charles-park/m1s_ups/sch/m1s_ups-REV1.0_20230712.png

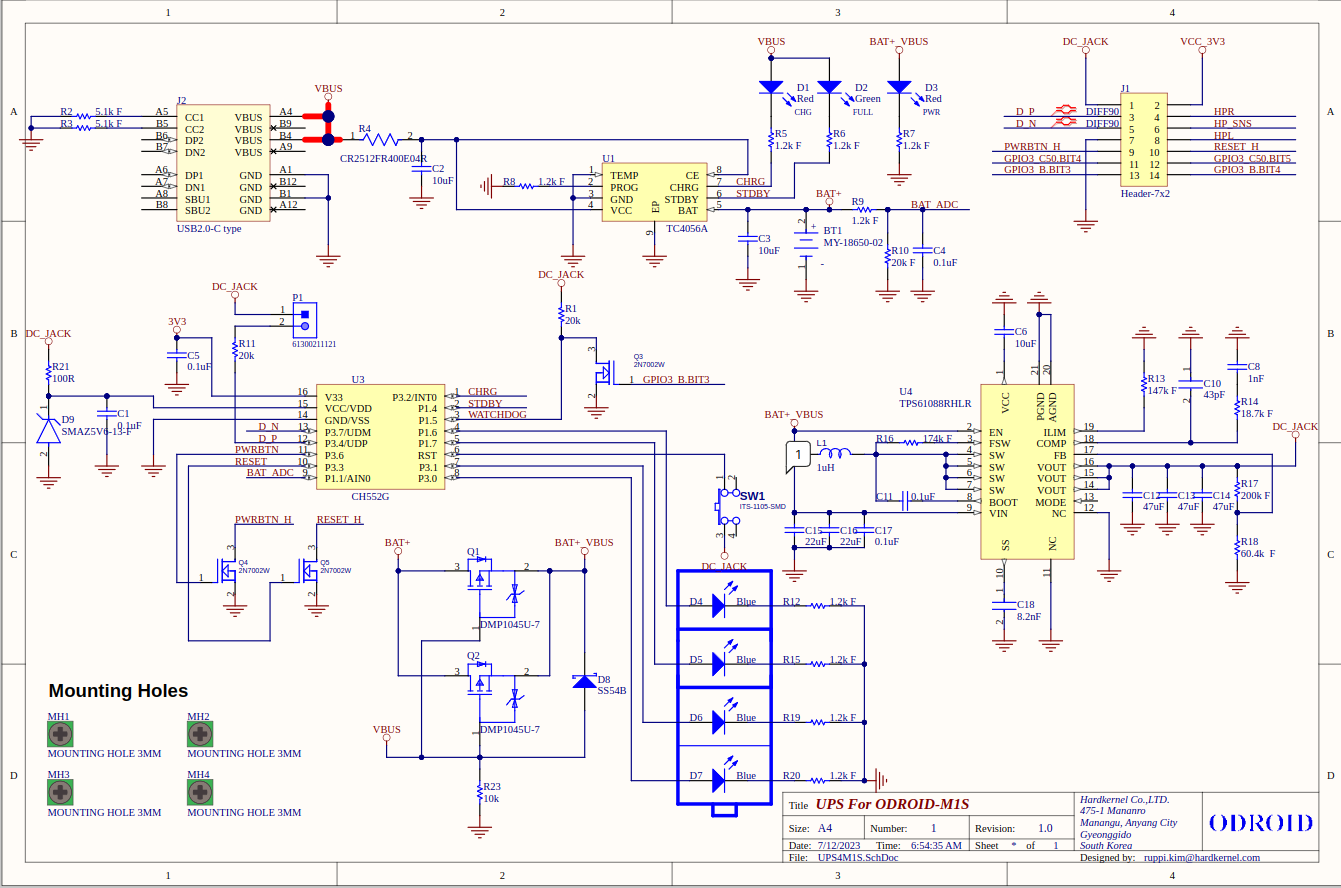
sch/m1s_ups-REV1.0_20230712.png
