charles-park/m1s_ups/sch/m1s_ups_rev1.0_230818.png

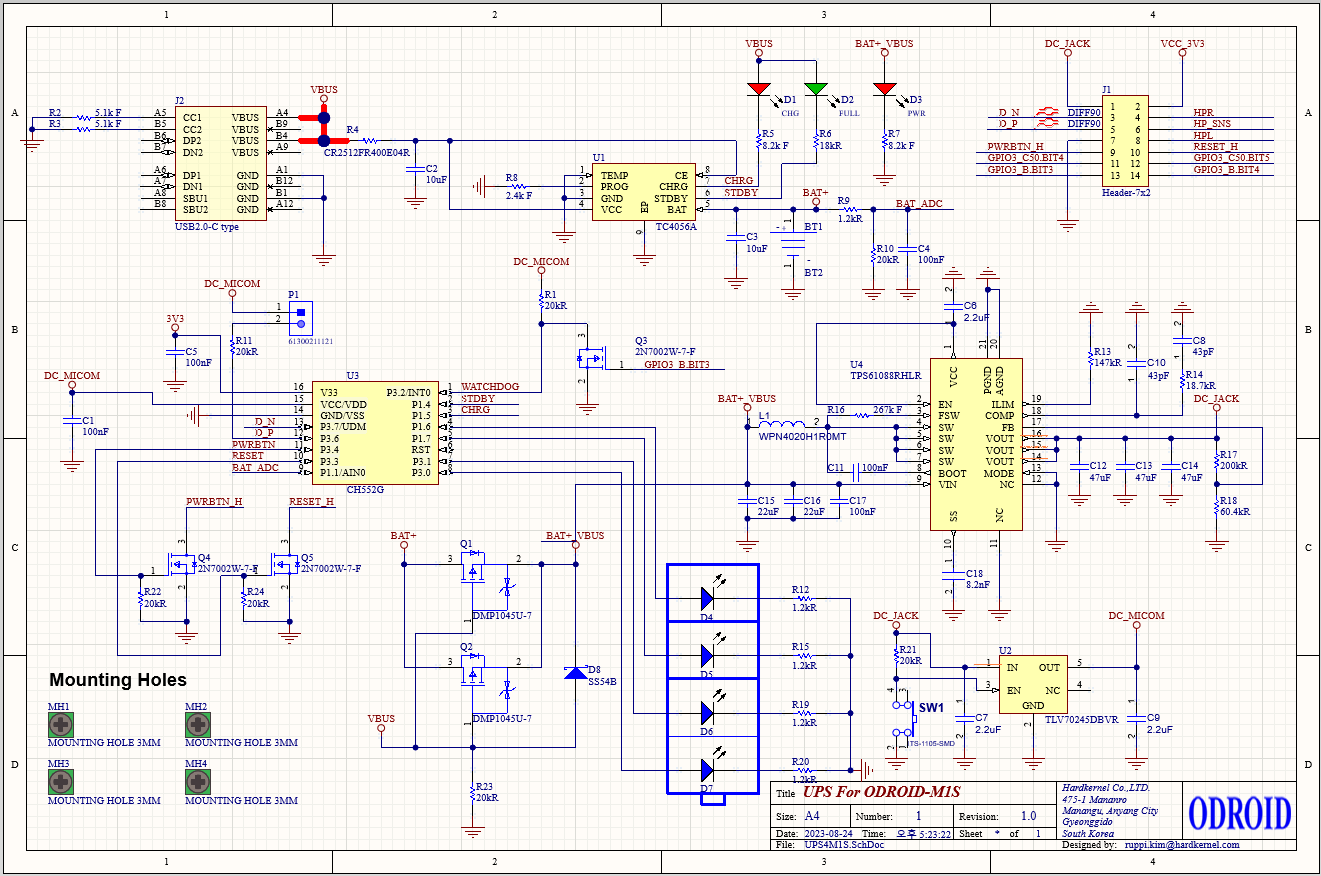
sch/m1s_ups_rev1.0_230818.png
