charles-park/m1s_ups/ups_fw/ups_fw.h

/*---------------------------------------------------------------------------*/
/**
 * @file ups_fw.h
 * @author charles-park (charles.park@hardkernel.com)
 * @brief M1S_UPS (Smart UPS Project)
 * @version 0.1
 * @date 2023-08-04
 *
 * @copyright Copyright (c) 2022
**/
/*---------------------------------------------------------------------------*/
#ifndef __UPS_FW_H__
#define __UPS_FW_H__

/*---------------------------------------------------------------------------*/
#include "include/ch5xx.h"

/*---------------------------------------------------------------------------*/
/* UPS System watchdog control */
/*---------------------------------------------------------------------------*/
#define GLOBAL_CFG_UNLOCK()     { SAFE_MOD = 0x55; SAFE_MOD = 0xAA;}
#define WDT_ENABLE()            ( GLOBAL_CFG |=  bWDOG_EN )
#define WDT_DISABLE()           ( GLOBAL_CFG &= ~bWDOG_EN )
#define WDT_CLR()               ( WDOG_COUNT  = 0 )

/* Use RESET_KEEP register to manage power states */
typedef union {
    struct {
        unsigned char   NotUsed             : 4;
        unsigned char   bGpioStatus         : 1;
        unsigned char   bRestartCondition   : 1;
        unsigned char   ePowerState         : 2;
    }   bits;
    unsigned char       byte;
}   regRESET_KEEP;

volatile regRESET_KEEP  rRESET_KEEP;

/*---------------------------------------------------------------------------*/
/* TC4056A Charger status check port */
/*---------------------------------------------------------------------------*/
/* CH552 GPIO P1.1 */
#define PORT_BAT_ADC    11

/* CH552 GPIO P1.4 */
#define PORT_LED_FULL   14

/* CH552 GPIO P1.5 */
#define PORT_LED_CHRG   15

/*---------------------------------------------------------------------------*/
/* Target watchdog control port */
/*---------------------------------------------------------------------------*/
/* CH552 GPIO P3.2 */
#define PORT_WATCHDOG   32

/*---------------------------------------------------------------------------*/
/* Target Power / Reset control port */
/*---------------------------------------------------------------------------*/
/* CH552 GPIO P3.6 */
#define PORT_CTL_POWER  34
/* CH552 GPIO P3.3 */
#define PORT_CTL_RESET  33

/*---------------------------------------------------------------------------*/
/* Battery level display port */
/*---------------------------------------------------------------------------*/
/* CH552 GPIO P3.0 */
#define PORT_LED_LV4    30
/* CH552 GPIO P3.1 */
#define PORT_LED_LV3    31
/* CH552 GPIO P1.7 */
#define PORT_LED_LV2    17
/* CH552 GPIO P1.6 */
#define PORT_LED_LV1    16

/*---------------------------------------------------------------------------*/
/* M1S_UPS H/W Value set-tup */
/*---------------------------------------------------------------------------*/
/* TLV70245DBVR LDO Output(4.5V) = 4500 mV */
#define MICOM_VDD_mV    4500

/* ADC 8 bits (256). mV resolution value */
//#define MICOM_ADC_RES   256
#define MICOM_ADC_RES   255
/* R9(1.2K) */
#define BAT_ADC_R1      1200
/* R10(20K) */
#define BAT_ADC_R2      20000

/*---------------------------------------------------------------------------*/
/* Battery Level (1 ~ 9) */
/* cal = 3500 + (level * 50) mV*/
/*---------------------------------------------------------------------------*/
#define BATTERY_LEVEL_3950mV    3950
#define BATTERY_LEVEL_3900mV    3900
#define BATTERY_LEVEL_3850mV    3850
#define BATTERY_LEVEL_3800mV    3800
#define BATTERY_LEVEL_3750mV    3750
#define BATTERY_LEVEL_3700mV    3700
#define BATTERY_LEVEL_3650mV    3650
#define BATTERY_LEVEL_3600mV    3600
#define BATTERY_LEVEL_3550mV    3550
/* Force off Battery level */
#define BATTERY_LEVEL_OFF       3300
#define BATTERY_BOOT_LEVEL      3500

/*---------------------------------------------------------------------------*/
/* Display Battery Level */
/*---------------------------------------------------------------------------*/
#define BATTERY_DISPLAY_LV4     BATTERY_LEVEL_3900mV
#define BATTERY_DISPLAY_LV3     BATTERY_LEVEL_3750mV
#define BATTERY_DISPLAY_LV2     BATTERY_LEVEL_3650mV
#define BATTERY_DISPLAY_LV1     BATTERY_LEVEL_3550mV

/*---------------------------------------------------------------------------*/
/* Set battery level for system power on */
/* Power on when battery charge condition detected.(default) */
/* 0     : Detect charging status.(default) */
/* 1 ~ 9 : BATTERY LEVEL, cal_volt = 3500 + (50 * value) */
/*---------------------------------------------------------------------------*/
__xdata unsigned long BatteryBootVolt = 0;

/*---------------------------------------------------------------------------*/
/* ADC Raw sample count. */
/*---------------------------------------------------------------------------*/
#define ADC_SAMPLE_CNT      10

/*---------------------------------------------------------------------------*/
/* 10 sec avr */
/*---------------------------------------------------------------------------*/
#define BAT_AVR_SAMPLE_CNT  20

__xdata float BatteryVoltSamples[BAT_AVR_SAMPLE_CNT];

/*---------------------------------------------------------------------------*/
/*
    Charger Status
                 | LED_CHARG_STATUS | LED_FULL_STATUS |
    Discharging  |         1        |        1        |
    Charging     |         0        |        1        |
    Full Charged |         1        |        0        |
    Error        |         0        |        0        | Battery Removed.
*/
/*---------------------------------------------------------------------------*/
__xdata bool LED_CHRG_STATUS = false;
__xdata bool LED_FULL_STATUS = false;

/*---------------------------------------------------------------------------*/
/* Battery level indicator LED status */
/*---------------------------------------------------------------------------*/
__xdata bool LED_LV1_STATUS = false;
__xdata bool LED_LV2_STATUS = false;
__xdata bool LED_LV3_STATUS = false;
__xdata bool LED_LV4_STATUS = false;

/*---------------------------------------------------------------------------*/
/* Serial Protocol */
/*---------------------------------------------------------------------------*/
#define PROTOCOL_SIZE   4

__xdata char Protocol[PROTOCOL_SIZE];

/*---------------------------------------------------------------------------*/
/* Power State */
/*---------------------------------------------------------------------------*/
enum {
    ePOWER_INIT = 0,
    ePOWER_ON,
    ePOWER_OFF,
    ePOWER_END,
}   ePOWER_STATE;

/*---------------------------------------------------------------------------*/
/* Battery Status */
/*---------------------------------------------------------------------------*/
enum {
    eBATTERY_DISCHARGING = 0,
    eBATTERY_CHARGING,
    eBATTERY_FULL,
    eBATTERY_REMOVED,
    eBATTERY_END,
}   eBATTERY_STATUS;

__xdata enum eBATTERY_STATUS BatteryStatus = eBATTERY_REMOVED;

/*---------------------------------------------------------------------------*/
/* Main Loop Control */
/*---------------------------------------------------------------------------*/
#define TARGET_RESET_DELAY      100

/* Main loop period */
#define PERIOD_LOOP_MILLIS      500

/* Off state period 2 sec (2000 - PERIOD_LOOP_MILLIS) */
#define PEROID_OFF_MILLIS       1500

/* Error display delay */
#define POWEROFF_LED_DELAY      100

__xdata unsigned long MillisLoop        = 0;
__xdata unsigned long BatteryAvrVolt    = 0;

/*---------------------------------------------------------------------------*/
/* Auto repeat data control */
/*---------------------------------------------------------------------------*/
__xdata unsigned long PeriodRequestBatteryLevel   = 0;
__xdata unsigned long MillisRequestBatteryLevel   = 0;

__xdata unsigned long PeriodRequestBatteryVoltage = 0;
__xdata unsigned long MillisRequestBatteryVoltage = 0;

__xdata unsigned long PeriodRequestChagerStatus   = 0;
__xdata unsigned long MillisRequestChagerStatus   = 0;

/*---------------------------------------------------------------------------*/
/* Target reset(watchdog) control */
/*---------------------------------------------------------------------------*/
__xdata unsigned long PeriodRequestWatchdogTime = 0;
__xdata unsigned long MillisRequestWatchdogTime = 0;

/*---------------------------------------------------------------------------*/
/*---------------------------------------------------------------------------*/
/* Function prototype define */
/*---------------------------------------------------------------------------*/
/*---------------------------------------------------------------------------*/
/*---------------------------------------------------------------------------*/
void            LED_SetState            (unsigned char state);
void            LED_Test                (void);

unsigned long   cal_battery_level       (unsigned int val);

float           battery_adc_volt_cal    (void);
float           battery_adc_volt        (void);
float           battery_volt            (void);
void            battery_avr_volt_init   (void);
float           battery_avr_volt        (enum eBATTERY_STATUS bat_status);

enum eBATTERY_STATUS battery_status     (void);

void            battery_level_display   (enum eBATTERY_STATUS bat_status, unsigned long bat_volt);
void            battery_level_update    (enum eBATTERY_STATUS bat_status, unsigned long bat_volt);

void            repeat_data_clear       (void);
void            repeat_data_check       (void);
void            request_data_send       (char cmd);
void            protocol_check          (void);

void            target_system_reset     (void);
void            target_system_power     (bool onoff);

void            power_state_check       (enum eBATTERY_STATUS bat_status, unsigned long bat_volt);
void            port_init               (void);
void            setup                   ();
void            loop                    ();

/*---------------------------------------------------------------------------*/
#endif  // __UPS_FW_H__

/*---------------------------------------------------------------------------*/
/*---------------------------------------------------------------------------*/
