charles-park/m1s_ups/(commit log)

2023-08-03 Update README.md
    Compile & Download 방법 기록(arm version기준)
2023-08-03 Update README.md
    vnproch55x를 이용한 download 방법
2023-08-04 Update README.md
    arduino-cli install 참조사이트 추가
2023-08-04 Update README.md
    ARM Board에 설치시 문제점에 대한 내용 추가
2023-08-04 Update README.md
    link 이동
2023-08-14 Firmware version string changed. charger status display changed
2023-08-14 ups watchdog enable. board rev에 대한 pin설정 추가
2023-08-14 ups 안정성관련 사항 수정
    [ups_fw.ino]
2023-08-14 Update README.md
    F/W download후 UART접근시 문제발생
    F/W download후에는 stty -F /dev/ttyACM0 9600 명령실행
    반드시 9600bps로 돌아가야 UART접근시 reset이 되지 않음.
2023-08-14 Power On Event 버그해결. bat avr초기화추가
2023-08-14 repeat data bug 수정
    [ups_fw.ino]
2023-08-14 target watchdog control 문제점 수정
    [ups_fw.ino]
2023-08-14 Battery remove 표시문제점 수정
    [ups_fw.ino]
2023-08-16 LED Indicator logic changed.
    LED 표시를 GPIO에서 바로 읽어 표시하는 경우 초기값은 항상 0으로 동작함.
    F/W update시에 시스템 RESET이 동작하지 않도록 수정(동작x)
    [ups_fw.ino]
2023-08-17 사용하지 않는 debug msg제거
2023-08-17 power상태 유지 로직 변경
2023-08-17 release f/w for new board
2023-08-18 case문 추가
2023-08-18 power on command 추가
2023-08-18 service 및 v0.1 fw release
2023-08-29 source 정리
2023-08-29 pcb rev 0.1 삭제. source정리
2023-08-29 irq test. adc res 256 -> 255
2023-08-29 pcb 20230818 sch
2023-08-31 디버그메세지 삭제, source파일 정리
2023-09-01 power on/off check & update
2023-09-01 변수명 변경, script수정
2023-09-01 스크립트 정리
2023-09-01 power button signal 수정
    [ups_fw.ino]
2023-09-01 gpio status 수정
2023-09-04 battery off voltage change 3400->3300
2023-09-04 script poweroff enable
2023-09-04 Update README.md
    vnproch55x github 추가
2023-11-22 완전방전후 재시작 문제점 해결
2023-11-22 release v0.5: 배터리 full방전시 다시켜지지 않는 문제점 및 on/off반복문제점 해결
2023-12-21 new f/w : status 동기화
